laneboysrc/rc-brake-lights-arduino/doc/arduino-nano.jpg

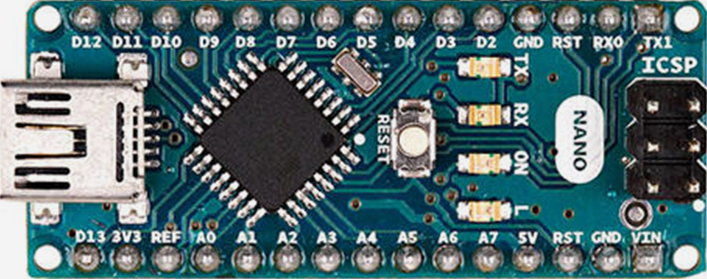
doc/arduino-nano.jpg
