laneboysrc/rc-brake-lights-arduino/doc/push-button.jpg

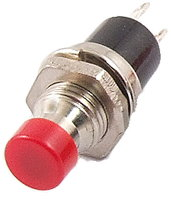
doc/push-button.jpg
